rene6262/FAllyx_EVK/Fallyx_EVK _BOM.xlsx

Fallyx_EVK BOM |  | RevA
Estimated Cost | $36.61
Designator | Mfg | Mfg Part ID | Description | QTY | COST/100 | Value | Footprint | ALT P/N
C1, C5, C7, C8, C15, C16, C19, C20, C21, C22, C26, C28, C36 | YAGEO | CC0603KRX7R7BB104 | CAP CER 0.1UF 16V X7R 0603 | 13 | $0.02 | 0.1uF | C0603
C2, C6, C14, C27, C41, C44 | Samsung Electro-Mechanics | CL10A475KP8NNNC | CAP CER 4.7UF 10V X5R 0603 | 6 | $0.02 | 4.7uF | C0603
C3, C45 | KEMET | C0603C151J5GACTU | CAP CER 150PF 50V C0G/NP0 0603 | 1 | $0.02 | 150pF | C0603
C4, C45 | Murata Electronics | GRM21BR61C106KE15K | CAP CER 10UF 16V X5R 0805 | 1 | $0.05 | 10uF | C0805
C23, C31, C35, C37 | Taiyo Yuden | JMK105BJ105KV-F | CAP CER 1UF 6.3V X5R 0402 | 4 | $0.01 | 1uF | C0402
C29, C30 | Murata Electronics | GRM155R60J106ME05D | CAP CER 10UF 6.3V X5R 0402 | 2 | $0.02 | 10uF | C0402
C33 | Samsung Electro-Mechanics | CL10A225KO8NNNC | CAP CER 2.2UF 16V X5R 0603 | 1 | $0.02 | 2.2uF | C0603
C38 | Murata Electronics | GCM155R71H223KA55D | CAP CER 0.022UF 50V X7R 0402 | 1 | $0.01 | 22nF | C0402
C17, C18, C24, C25, C39 | Murata Electronics | GRM1555C1H100JA01D | CAP CER 10PF 50V C0G/NP0 0402 | 5 | $0.01 | 10pF | C0402
C32 | Murata Electronics | GRM155R61A474KE15D | CAP CER 0.47UF 10V X5R 0402 | 1 | $0.04 | 0.47uF | C0402
C34, C40 | Samsung Electro-Mechanics | CL10A226MP8NUNE | CAP CER 22UF 10V X5R 0603 | 2 | $0.07 | 22uF | C0603
C42, C43 | Johanson Technology Inc. | QSCF500Q1R2B1GV001T | CAP CER 1.2PF 50V C0G/NP0 0402 | 2 | $0.05 | 1.2pF | C0402
D1 | Würth Elektronik | 150060VS75000 | LED GREEN CLEAR 0603 SMD | 1 | $0.11 |  | C0603
D2 | Würth Elektronik | 150060SS75000 | LED RED CLEAR 0603 SMD | 1 | $0.11 |  | C0603
D3 | Würth Elektronik | 150060AS75000 | LED AMBER CLEAR 0603 SMD | 1 | $0.11 |  | C0603
D4, D6 | Kingbright | APG0603SURC-TT | LED RED CLEAR 2SMD | 1 | $0.19 |  | C0201
D5 | onsemi | RB521S30T1G | DIODE SCHOTTKY 30V 200MA SOD523 | DNP | $0.04 |  | SOD523
FB2 | Würth Elektronik | 7427927261 | FERRITE BEAD 600 OHM 0402 4LN | 1 | $0.15
J1 |  |  | 5PIN | DNP
J2, J3 |  |  | 6PIN | DNP
J4 |  |  | 8PIN | DNP
J5 |  |  | DNP | DNP
J6 | GCT | USB4135-GF-A | USB C REC GF RA 6P SMT & SMT SHE | 1 | $0.44
J9 | Hirose Electric Co Ltd | U.FL-R-SMT-1(80) | CONN U.FL RCPT STR 50 OHM SMD | 1 | $0.78
J12 |  |  | 40PIN | DNP
J13 |  |  | 9PIN | DNP
L1, L3 | Taiyo Yuden | NR3015T4R7M | FIXED IND 4.7UH 1.04A 144MOHM SM | 2 | $0.19 | 4.7uH
L2 | TDK Corporation | MLG1005S3N3ST000 | FIXED IND 3.3NH 800MA 200MOHM SM | 1 | $0.07 | 3.3nH | L0402
R1, R27 | Panasonic Electronic Components | ERJ-6GEY0R00V | RES SMD 0 OHM JUMPER 1/8W 0805 | 1 | $0.02 | 0Ohm | R0805
R2 | TE Connectivity Passive Product | CPF0402B200KE | RES SMD 200K OHM 0.1% 1/16W 0402 | 1 | $0.16 | 200kOhm | R0402
R3 | TE Connectivity Passive Product | CPF0402B150KE1 | RES SMD 150K OHM 0.1% 1/16W 0402 | 1 | $0.20 | 150kOhm | R0402
R16, R17 | Panasonic Electronic Components | ERA-2AEB512X | RES SMD 5.1K OHM 0.1% 1/16W 0402 | 2 | $0.09 | 5.1k | R0402
R8, R19 | YAGEO | RC0402JR-07100KL | RES 100K OHM 5% 1/16W 0402 | DNP | $0.0041 | 100k | R0402
R9, R10 | YAGEO | RC0402JR-07100KL | RES 100K OHM 5% 1/16W 0402 | 2 | $0.0041 | 100k | R0402
R4, R5, R6, R7, R18, R14, R15, R28 | YAGEO | RC0402JR-0710KL | RES 10K OHM 5% 1/16W 0402 | 8 | $0.01 | 10k | R0402
R20, R23, R24, R25, R26, R29 | YAGEO | RC0402JR-071KL | RES 1K OHM 5% 1/16W 0402 | 6 | $0.01 | 1k | R0402
R30 | YAGEO | RC0402JR-074K7L | RES 4.7K OHM 5% 1/16W 0402 | 1 | $0.0041 | 4.7k | R0402
R31 | TE Connectivity Passive Product | CRGCQ0402F330K | RES 330K OHM 1% 1/16W 0402 | 1 | $0.01 | 330k | R0402
R32 | Panasonic Electronic Components | ERJ-2RKF1603X | RES SMD 160K OHM 1% 1/10W 0402 | 1 | $0.01 | 160k | R0402
S1 | Same Sky (Formerly CUI Devices) | TS04-66-50-BK-100-SMT | SWITCH TACTILE SPST-NO 0.05A 12V | 1 | $0.14
Q1 | Infineon Technologies | IRLML6344TRPBF | MOSFET N-CH 30V 5A MICRO3/SOT23 | 1 | $0.18 |  | SOT23
Q2 | LRC | LMBT3904WT1G | 40V 150mW 40@0.1mA,10V 200mA NPN SOT-323-3 Bipolar (BJT) ROHS | 1 | $0.01 |  | SOT323
IC1 | onsemi | NCH-RSL10-101S51-ACG | IC RF TXRX+MCU BLE 51SIP | 1 | $11.17
IC2 | Silicon Labs | BGM111A256V21R | RF TXRX MOD BLUETOOTH CHIP SMD | 1 | $8.93
U1, U10 | Torex Semiconductor Ltd | XC9236F08CER-G | IC REG BUCK ADJ 600MA 6USPC | 1 | $1.29 |  | 6-UFDFN
U2 | STMicroelectronics | ILPS22QSTR | SENSOR 58.89PSIA 24BIT 10HLGA | 1 | $2.49 |  | 10-WFLGA
U3 | Bosch Sensortec | BMI270 | IMU ACCEL/GYRO I2C/SPI 14LGA | 1 | $3.03 |  | 14HLGA
U4 | STMicroelectronics | STM32L431CBT6 | IC MCU 32BIT 128KB FLASH 48LQFP | 1 | $2.12 |  | 48-LQFP
U5 | Macronix | MX25R6435FZNIL0 | IC FLASH 64MBIT SPI/QUAD 8WSON | 1 | $1.55
U6 | Microchip Technology | MCP73831T-2ACI/OT | IC BATT CNTL LI-ION 1CEL SOT23-5 | 1 | $0.61 |  | SOT235
X1 | ECS Inc. | ECS-320-CDX-2094 | CRYSTAL 32.000MHZ 10PF SMD | 1 | $0.40
X2 | Jauch Quartz | Q 0,032768-JTX110-9-20-T1-90K-LF | CRYSTAL 32.7680KHZ 9PF SMD | 1 | $0.78
