rene6262/FAllyx_EVK/Fallyx_EVK-RevA.kicad_pcb

## KiCad design Fallyx_EVK-RevA.kicad_pcb (2025-02-08)

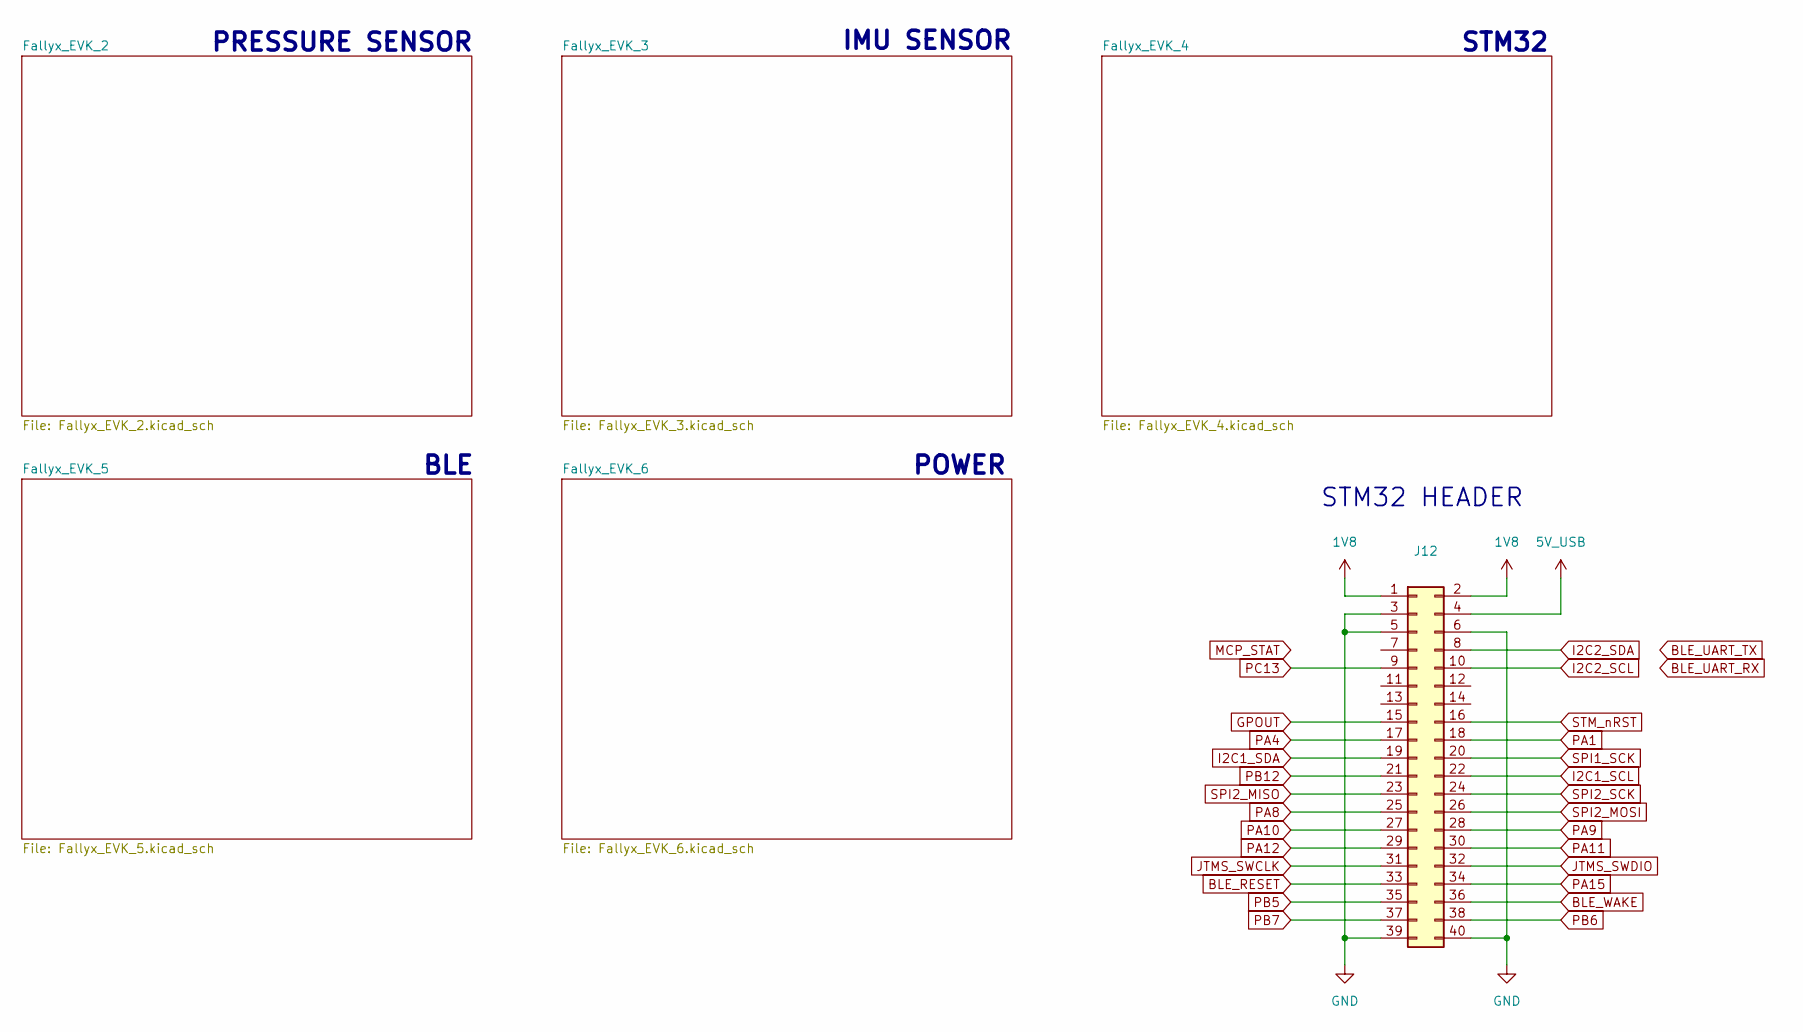
[picture p1: schematic Fallyx_EVK-RevA.kicad_sch]

Parts:
J12: Conn_02x20_Odd_Even; PinHeader_2x20_P2.54mm_Vertical

Connections:
1V8: J12.1, J12.2; also elsewhere on the board
5V_USB: J12.4; also elsewhere on the board
BLE_RESET: J12.33; also elsewhere on the board
BLE_UART_RX: J12.10; also elsewhere on the board
BLE_UART_TX: J12.8; also elsewhere on the board
BLE_WAKE: J12.36; also elsewhere on the board
GND: J12.3, J12.5, J12.6, J12.39, J12.40; also elsewhere on the board
GPOUT: J12.15; also elsewhere on the board
I2C1_SCL: J12.22; also elsewhere on the board
I2C1_SDA: J12.19; also elsewhere on the board
JTMS_SWCLK: J12.31; also elsewhere on the board
JTMS_SWDIO: J12.32; also elsewhere on the board
PA1: J12.18; also elsewhere on the board
PA4: J12.17; also elsewhere on the board
PA8: J12.25; also elsewhere on the board
PA9: J12.28; also elsewhere on the board
PA10: J12.27; also elsewhere on the board
PA11: J12.30; also elsewhere on the board
PA12: J12.29; also elsewhere on the board
PA15: J12.34; also elsewhere on the board
PB5: J12.35; also elsewhere on the board
PB6: J12.38; also elsewhere on the board
PB7: J12.37; also elsewhere on the board
PB12: J12.21; also elsewhere on the board
PC13: J12.9; also elsewhere on the board
SPI1_SCK: J12.20; also elsewhere on the board
SPI2_MISO: J12.23; also elsewhere on the board
SPI2_MOSI: J12.26; also elsewhere on the board
SPI2_SCK: J12.24; also elsewhere on the board
STM_nRST: J12.16; also elsewhere on the board

Notes on the sheet:
STM32 HEADER
BLE
POWER
STM32
IMU SENSOR
PRESSURE SENSOR

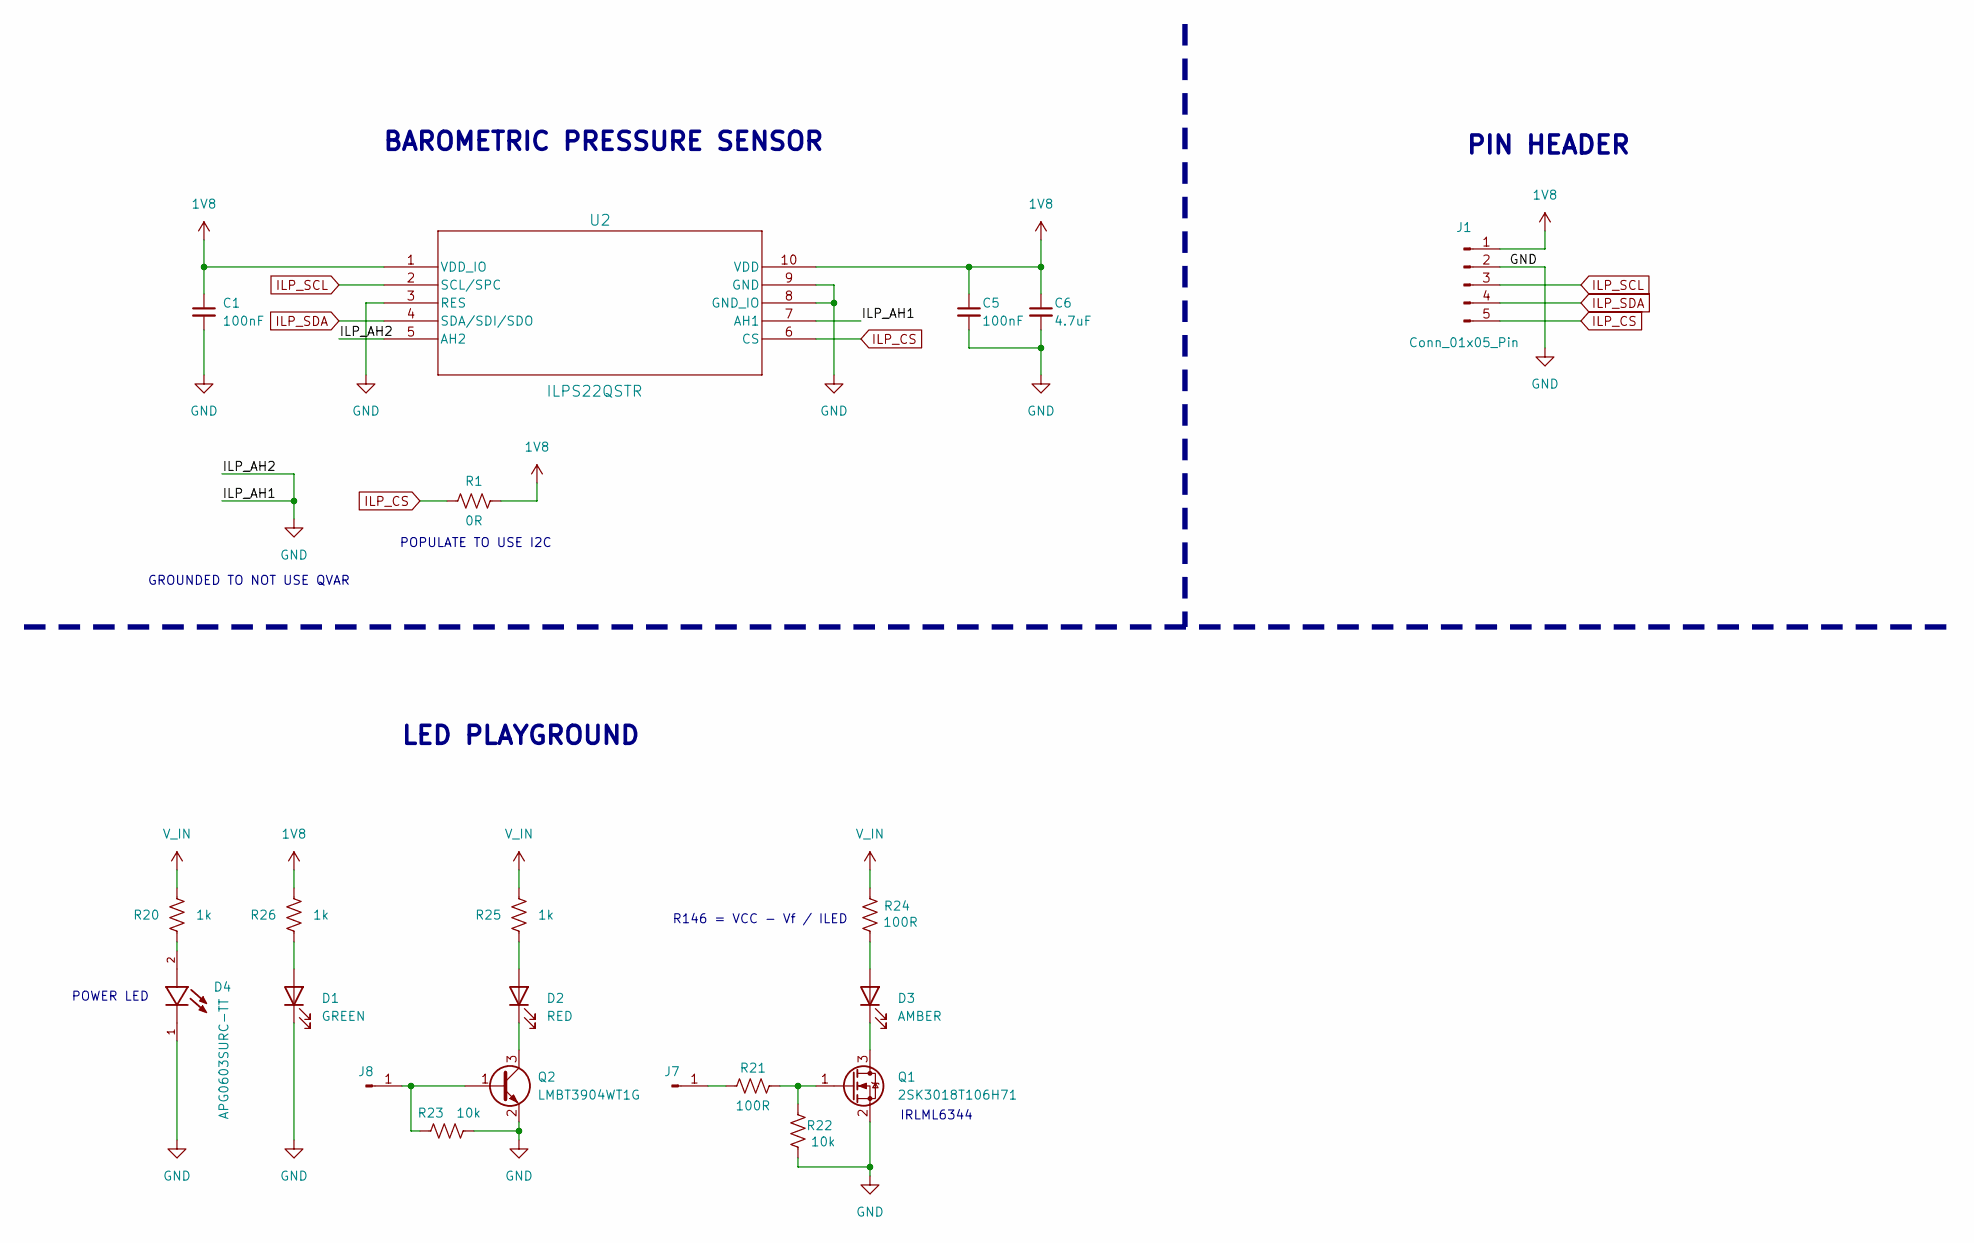
[picture p2: schematic Fallyx_EVK_2.kicad_sch]

Parts:
C1, C5: 100nF; C_0603_1608Metric
C6: 4.7uF; C_0603_1608Metric
D1: GREEN; LED_0603_1608Metric
D2: RED; LED_0603_1608Metric
D3: AMBER; LED_0603_1608Metric
D4: APG0603SURC-TT; LED_APG0603SURC-TT; PARTREV V.9B
J1: Conn_01x05_Pin; PinHeader_1x05_P2.54mm_Vertical
J7, J8: Conn_01x01_Pin; PinHeader_1x01_P2.54mm_Vertical
Q1: 2SK3018T106H71; SOT-323_SC-70
Q2: LMBT3904WT1G; SOT-23
R1: 0R; R_0805_2012Metric
R20, R25, R26: 1k; R_0402_1005Metric
R21, R24: 100R; R_0402_1005Metric
R22, R23: 10k; R_0402_1005Metric
U2: ILPS22QSTR; HLGA_10L_STM

Connections:
1V8: C1.1, C5.1, C6.1, J1.1, R1.2, R26.1, U2.1 (VDD_IO), U2.10 (VDD); also elsewhere on the board
GND: C1.2, C5.2, C6.2, D1.1 (K), D4.1, J1.2, Q1.2 (S), Q2.2 (E), R22.2, R23.1, U2.3 (RES), U2.5 (AH2), U2.7 (AH1), U2.8 (GND_IO), U2.9 (GND); also elsewhere on the board
ILP_CS: J1.5, R1.1, U2.6 (CS)
ILP_SCL: J1.3, U2.2 (SCL/SPC)
ILP_SDA: J1.4, U2.4 (SDA/SDI/SDO)
unnamed: D1.2 (A), R26.2
unnamed: D2.2 (A), R25.2
unnamed: D2.1 (K), Q2.3 (C)
unnamed: D3.2 (A), R24.2
unnamed: D3.1 (K), Q1.3 (D)
unnamed: D4.2, R20.2
unnamed: J7.1, R21.2
unnamed: J8.1, Q2.1 (B), R23.2
unnamed: Q1.1 (G), R21.1, R22.1
V_IN: R20.1, R24.1, R25.1; also elsewhere on the board

Notes on the sheet:
GROUNDED TO NOT USE QVAR
PIN HEADER
POPULATE TO USE I2C
IRLML6344
BAROMETRIC PRESSURE SENSOR
LED PLAYGROUND
POWER LED
R146 = VCC - Vf / ILED

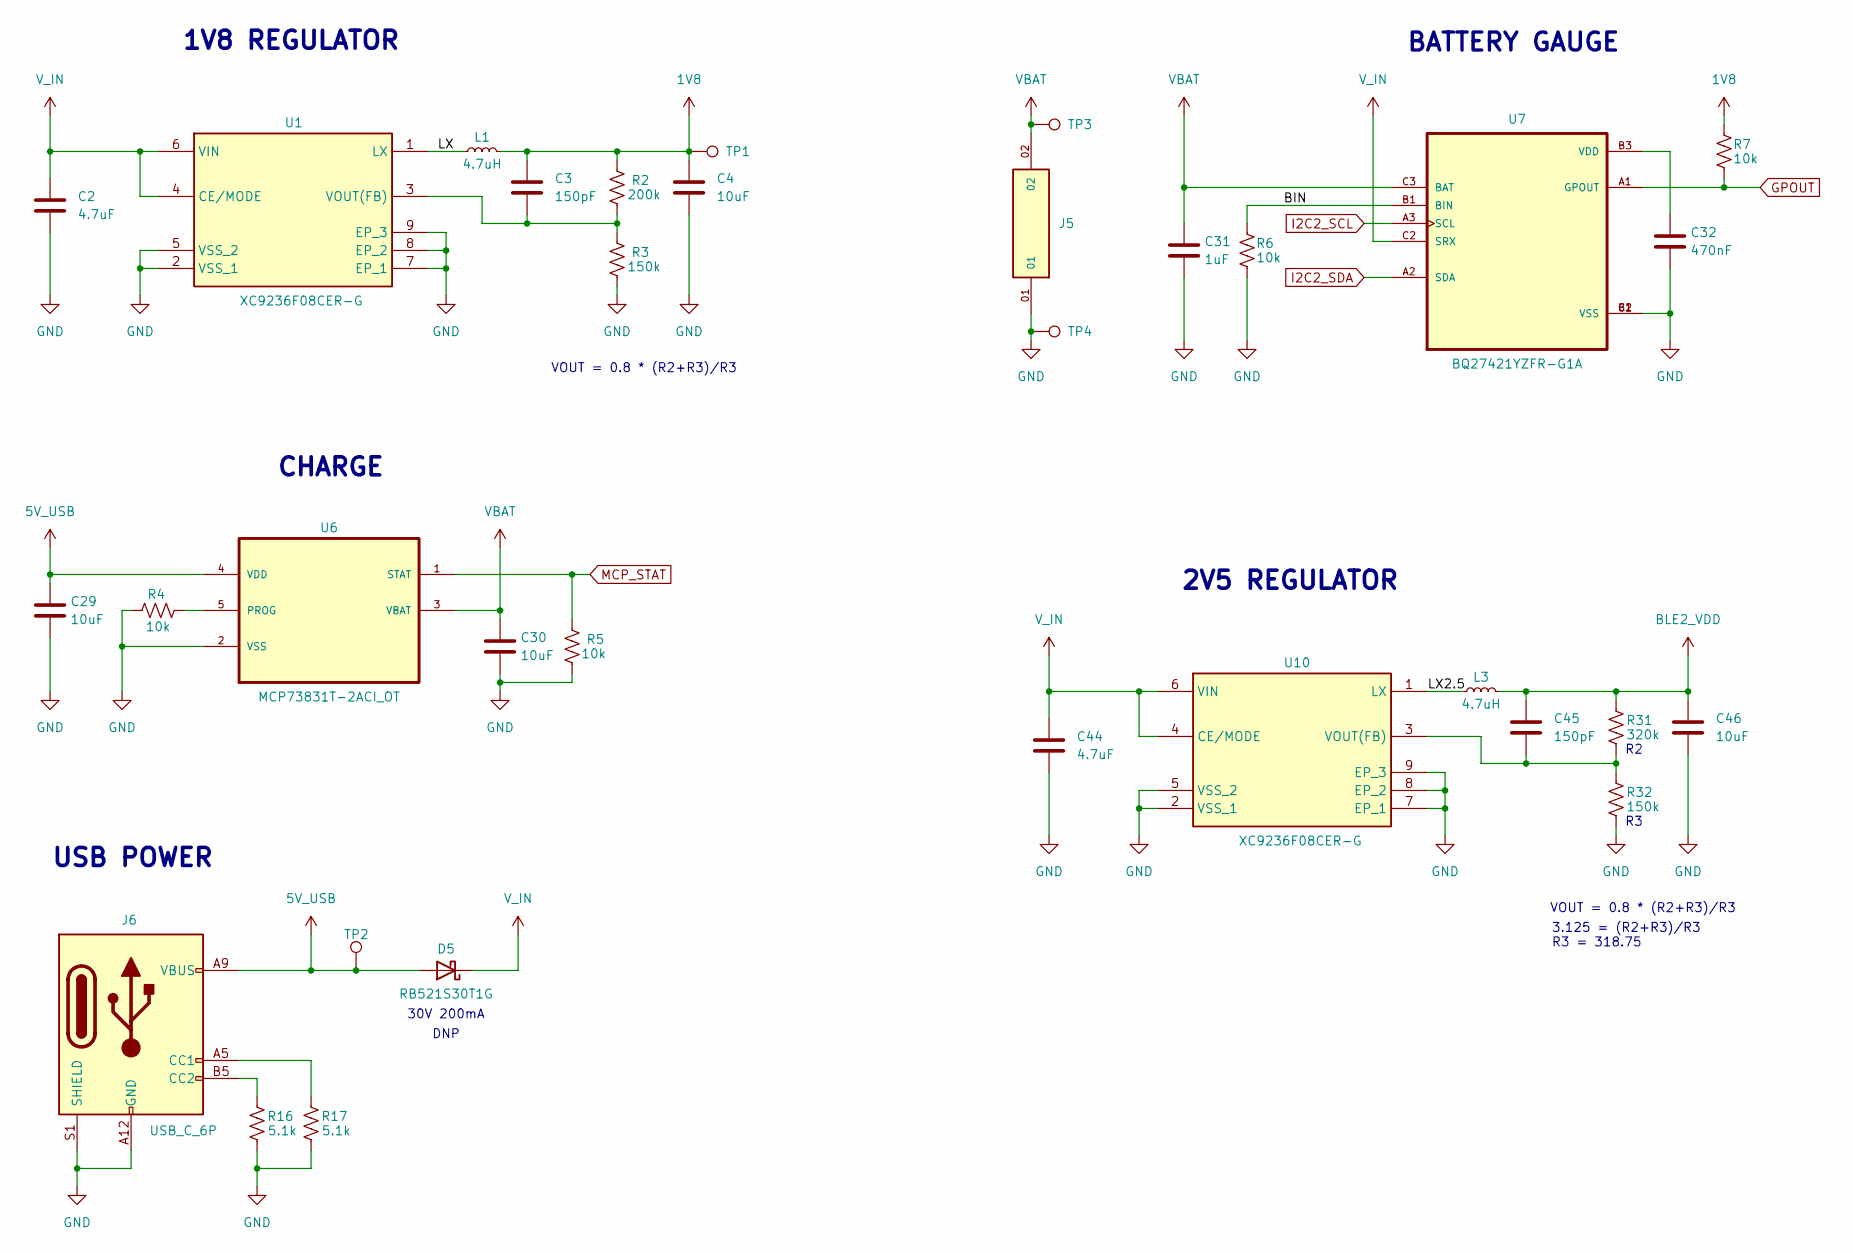
[picture p3: schematic Fallyx_EVK_6.kicad_sch]

Parts:
C2, C44: 4.7uF; C_0603_1608Metric
C3, C45: 150pF; C_0603_1608Metric
C4, C46: 10uF; C_0805_2012Metric
C29, C30: 10uF; C_0402_1005Metric
C31: 1uF; C_0402_1005Metric
C32: 470nF; C_0402_1005Metric
D5: RB521S30T1G; DIOM168X70N
J5: MTSW-101-X-X-D-X; SAMTEC_MTSW-101-X-X-D-X; PARTREV A
J6: USB_C_6P; USB_C_Receptacle_GCT_USB4135-GF-A_6P_TopMnt_Horizontal
L1, L3: 4.7uH; IND_TAIYO_NR3015_TAY
R2: 200k; R_0402_1005Metric
R3, R32: 150k; R_0402_1005Metric
R4, R5, R6, R7: 10k; R_0402_1005Metric
R16, R17: 5.1k; R_0402_1005Metric
R31: 320k; R_0402_1005Metric
TP1, TP2, TP3, TP4: TestPoint; TestPoint_Pad_D1.5mm
U1, U10: XC9236F08CER-G; XC9236F08CERG; Mouser Part Number 865-XC9236F08CER-G
U6: MCP73831T-2ACI_OT; SOT95P280X145-5N; MPN MCP73831T-2ACI/OT
U7: BQ27421YZFR-G1A; IC_BQ27421YZFR-G1A

Connections:
1V8: C3.1, C4.1, L1.2, R2.2, R7.2, TP1.1; also elsewhere on the board
5V_USB: C29.1, D5.2 (A), J6.A9 (VBUS), J6.B9 (VBUS), TP2.1, U6.4 (VDD); also elsewhere on the board
/Fallyx_EVK_6/BIN: R6.2, U7.B1 (BIN)
/Fallyx_EVK_6/LX: L1.1, U1.1 (LX)
/Fallyx_EVK_6/LX2.5: L3.1, U10.1 (LX)
BLE2_VDD: C45.1, C46.1, L3.2, R31.2; also elsewhere on the board
BLE_UART_RX: U7.A3 (SCL); also elsewhere on the board
BLE_UART_TX: U7.A2 (SDA); also elsewhere on the board
GND: C2.2, C4.2, C29.2, C30.2, C31.2, C32.2, C44.2, C46.2, J5.01, J6.A12 (GND), J6.B12 (GND), J6.S1 (SHIELD), R3.1, R4.2, R5.1, R6.1, R16.1, R17.1, R32.1, TP4.1, U1.2 (VSS_1), U1.5 (VSS_2), U1.7 (EP_1), U1.8 (EP_2), U1.9 (EP_3), U6.2 (VSS), U7.B2 (VSS), U7.C1 (VSS), U10.2 (VSS_1), U10.5 (VSS_2), U10.7 (EP_1), U10.8 (EP_2), U10.9 (EP_3); also elsewhere on the board
GPOUT: R7.1, U7.A1 (GPOUT); also elsewhere on the board
MCP_STAT: R5.2, U6.1 (STAT); also elsewhere on the board
unnamed: J6.A5 (CC1), R17.2
unnamed: J6.B5 (CC2), R16.2
unnamed: C3.2, R2.1, R3.2, U1.3 (VOUT(FB))
unnamed: R4.1, U6.5 (PROG)
unnamed: C32.1, U7.B3 (VDD)
unnamed: C45.2, R31.1, R32.2, U10.3 (VOUT(FB))
VBAT: C30.1, C31.1, J5.02, TP3.1, U6.3 (VBAT), U7.C3 (BAT); also elsewhere on the board
V_IN: C2.1, C44.1, D5.1 (K), U1.4 (CE/MODE), U1.6 (VIN), U7.C2 (SRX), U10.4 (CE/MODE), U10.6 (VIN); also elsewhere on the board

Notes on the sheet:
USB POWER
VOUT = 0.8 * (R2+R3)/R3
30V 200mA
1V8 REGULATOR
DNP
BATTERY GAUGE
3.125 = (R2+R3)/R3 R3 = 318.75
CHARGE
2V5 REGULATOR

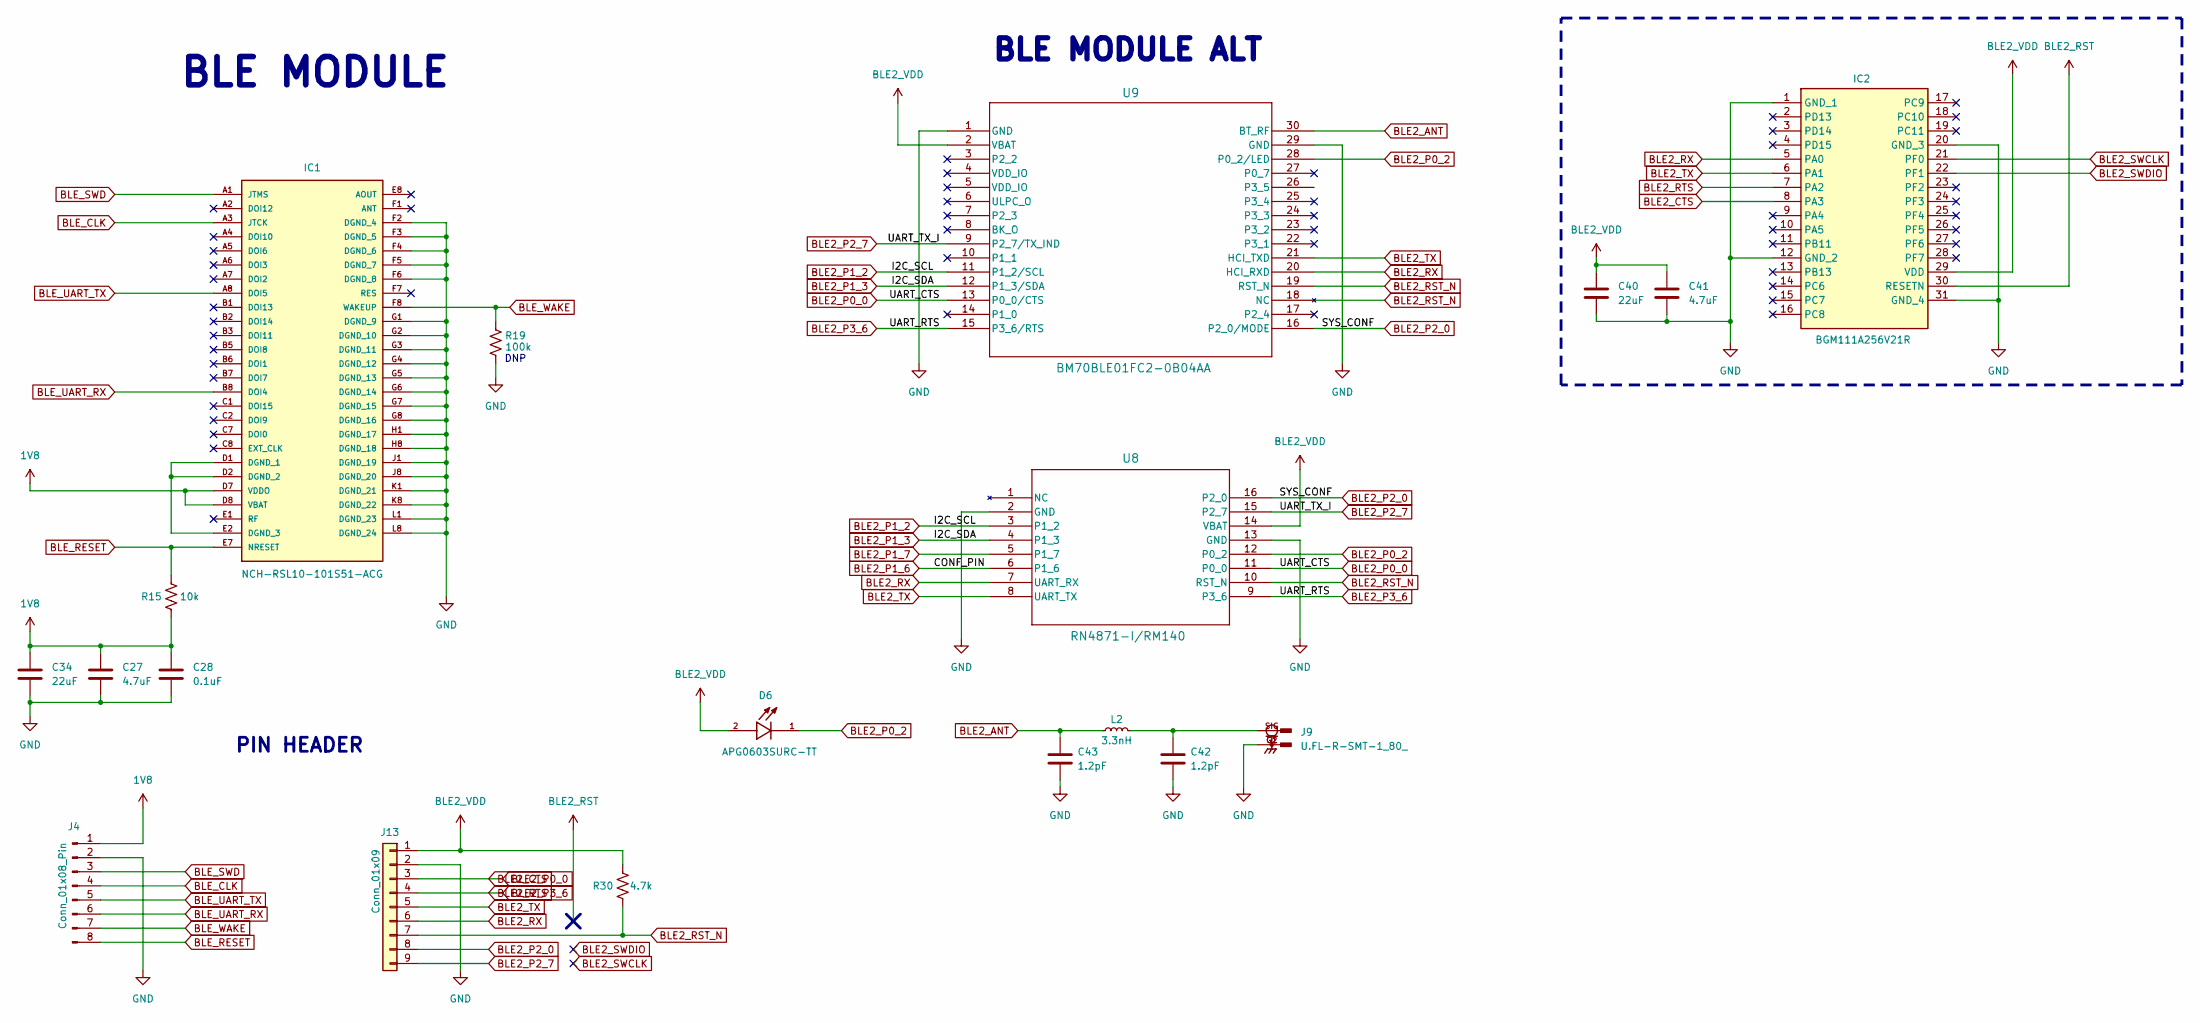
[picture p4: schematic Fallyx_EVK_5.kicad_sch]

Parts:
C27, C41: 4.7uF; C_0603_1608Metric
C28: 0.1uF; C_0402_1005Metric
C34, C40: 22uF; C_0603_1608Metric
C42, C43: 1.2pF; C_0402_1005Metric
D6: APG0603SURC-TT; LED_APG0603SURC-TT; PARTREV V.9B
IC1: NCH-RSL10-101S51-ACG; NCHRSL10101S51ACG; Mouser_Part_Number 863-NCHRSL1010S51ACG
IC2: BGM111A256V21R; Mouser Part Number 634-BGM111A256V21R
J4: Conn_01x08_Pin; PinHeader_1x08_P2.54mm_Vertical
J9: U.FL-R-SMT-1_80_; HIROSE_U.FL-R-SMT-1_80_; PARTREV Jul.1.2022
J13: Conn_01x09; PinHeader_1x09_P2.54mm_Vertical
L2: 3.3nH; L_0402_1005Metric
R15: 10k; R_0402_1005Metric
R19: 100k; R_0402_1005Metric
R30: 4.7k; R_0402_1005Metric
U8: RN4871-I/RM140; Microchip_RN4871
U9: BM70BLE01FC2-0B04AA; BM70BLE01FC2_MCH

Connections:
1V8: C27.1, C28.1, C34.1, IC1.D7 (VDDO), IC1.D8 (VBAT), J4.1, R15.1; also elsewhere on the board
BLE2_ANT: C43.1, L2.1, U9.30 (BT_RF)
BLE2_CTS: IC2.8 (PA3), J13.3, U8.11 (P0_0), U9.13 (P0_0/CTS)
BLE2_P0_2: D6.1, U8.12 (P0_2), U9.28 (P0_2/LED)
BLE2_P1_2: U8.3 (P1_2), U9.11 (P1_2/SCL)
BLE2_P1_3: U8.4 (P1_3), U9.12 (P1_3/SDA)
BLE2_P1_6: U8.6 (P1_6)
BLE2_P1_7: U8.5 (P1_7)
BLE2_P2_0: J13.8, U8.16 (P2_0), U9.16 (P2_0/MODE)
BLE2_P2_7: J13.9, U8.15 (P2_7), U9.9 (P2_7/TX_IND)
BLE2_P3_6: IC2.7 (PA2), J13.4, U8.9 (P3_6), U9.15 (P3_6/RTS)
BLE2_RST_N: J13.7, R30.1, U8.10 (RST_N), U9.18 (NC), U9.19 (RST_N)
BLE2_RX: IC2.5 (PA0), J13.6, U8.7 (UART_RX), U9.20 (HCI_RXD)
BLE2_TX: IC2.6 (PA1), J13.5, U8.8 (UART_TX), U9.21 (HCI_TXD)
BLE2_VDD: C40.1, C41.1, D6.2, IC2.29 (VDD), J13.1, R30.2, U8.14 (VBAT), U9.2 (VBAT); also elsewhere on the board
BLE_CLK: IC1.A3 (JTCK), J4.4
BLE_RESET: IC1.E7 (NRESET), J4.8, R15.2; also elsewhere on the board
BLE_SWD: IC1.A1 (JTMS), J4.3
BLE_UART_RX: IC1.B8 (DOI4), J4.6; also elsewhere on the board
BLE_UART_TX: IC1.A8 (DOI5), J4.5; also elsewhere on the board
BLE_WAKE: IC1.F8 (WAKEUP), J4.7, R19.2; also elsewhere on the board
GND: C27.2, C28.2, C34.2, C40.2, C41.2, C42.2, C43.2, IC1.F2 (DGND_4), IC1.F3 (DGND_5), IC1.F4 (DGND_6), IC1.F5 (DGND_7), IC1.F6 (DGND_8), IC1.G1 (DGND_9), IC1.G2 (DGND_10), IC1.G3 (DGND_11), IC1.G4 (DGND_12), IC1.G5 (DGND_13), IC1.G6 (DGND_14), IC1.G7 (DGND_15), IC1.G8 (DGND_16), IC1.H1 (DGND_17), IC1.H8 (DGND_18), IC1.J1 (DGND_19), IC1.J8 (DGND_20), IC1.K1 (DGND_21), IC1.K8 (DGND_22), IC1.L1 (DGND_23), IC1.L8 (DGND_24), IC2.1 (GND_1), IC2.12 (GND_2), IC2.20 (GND_3), IC2.31 (GND_4), J4.2, J9.G1, J9.G2, J13.2, R19.1, U8.2 (GND), U8.13 (GND), U9.1 (GND), U9.29 (GND); also elsewhere on the board
unnamed: C42.1, J9.SIG, L2.2
unnamed: IC1.D1 (DGND_1), IC1.D2 (DGND_2), IC1.E2 (DGND_3)

Notes on the sheet:
PIN HEADER
DNP
BLE MODULE
BLE MODULE ALT

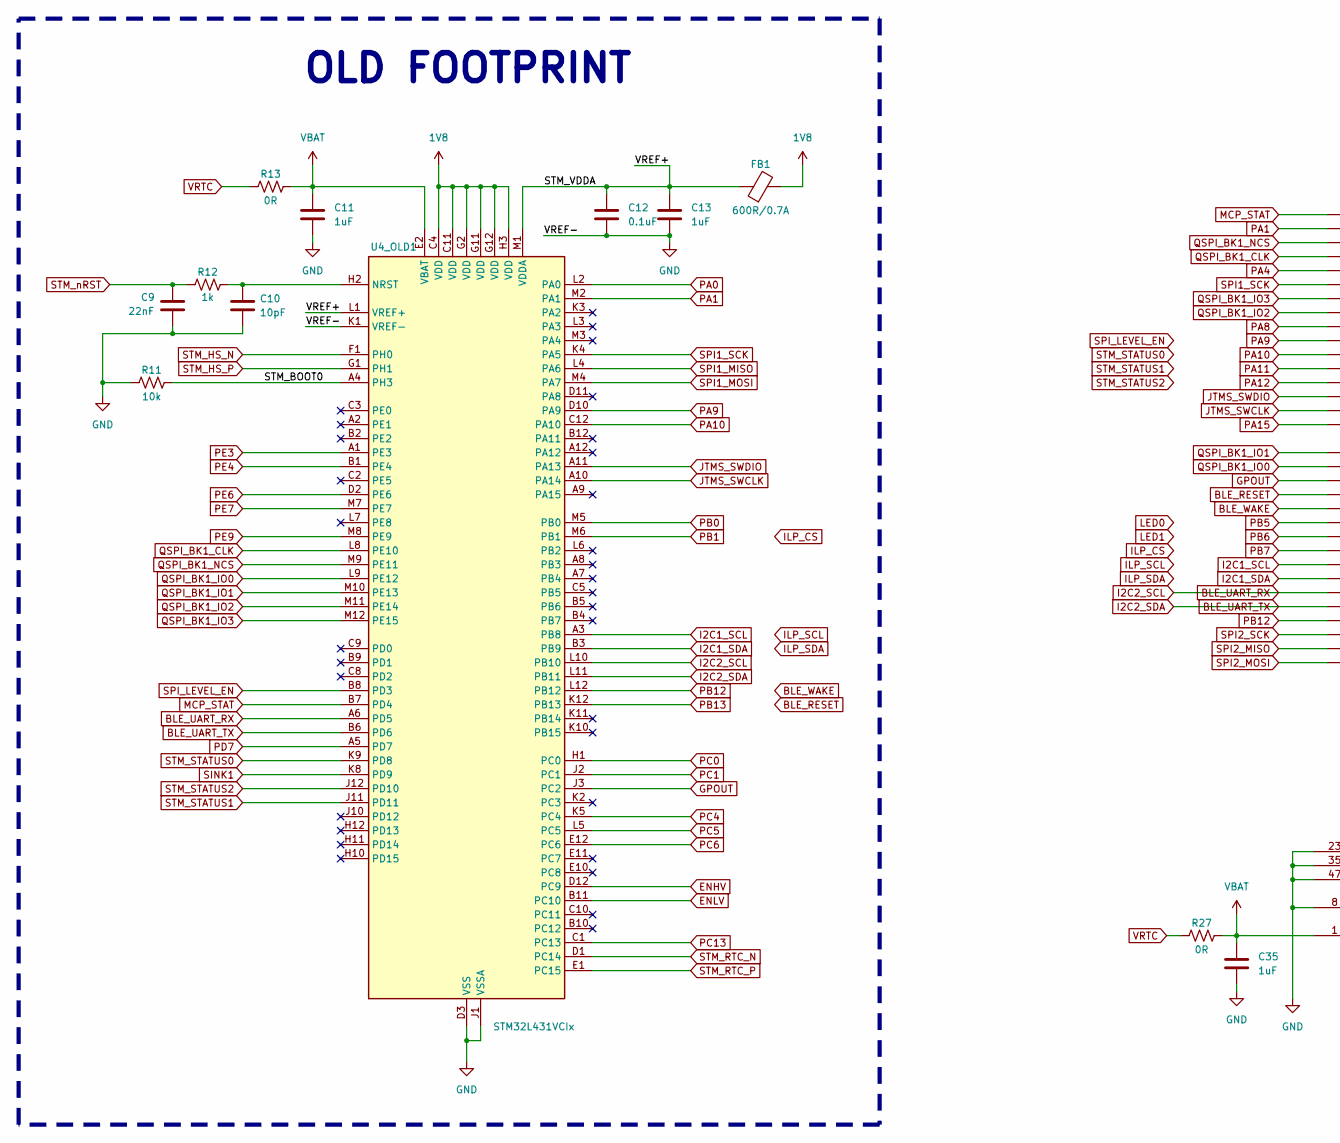
[picture p5: schematic Fallyx_EVK_4.kicad_sch, part in row 1, column 1]

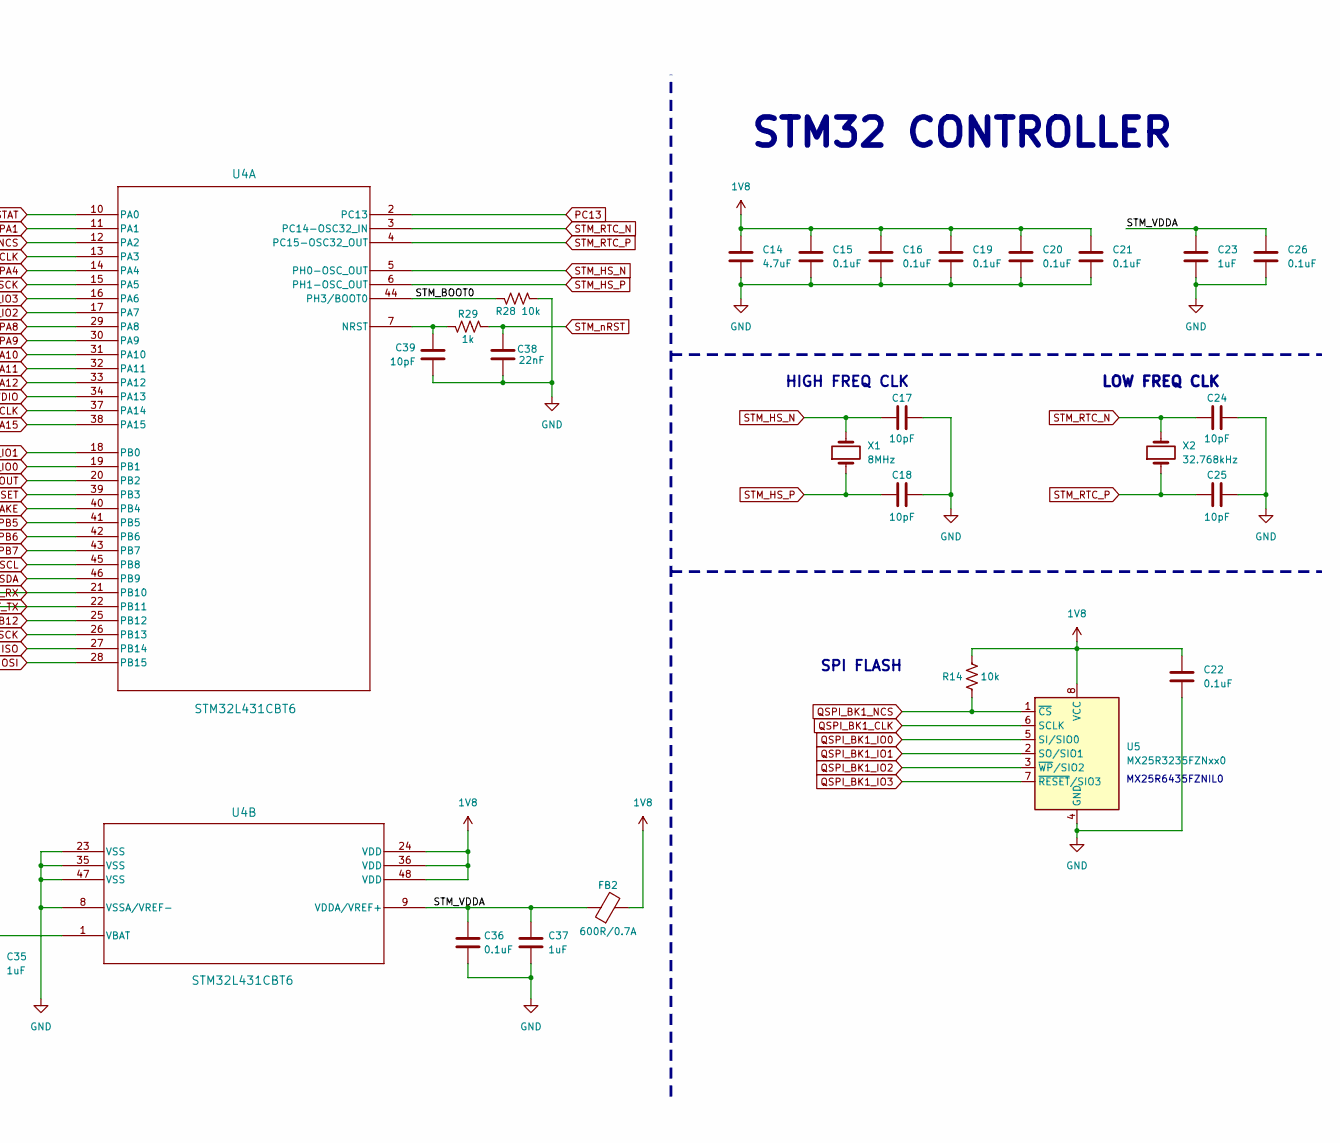
[picture p6: schematic Fallyx_EVK_4.kicad_sch, part in row 1, column 2]

Parts:
C9, C38: 22nF; C_0402_1005Metric
C10, C17, C18, C24, C25, C39: 10pF; C_0402_1005Metric
C11, C13, C23, C35, C37: 1uF; C_0402_1005Metric
C12, C15, C16, C19, C20, C21, C22, C26, C36: 0.1uF; C_0402_1005Metric
C14: 4.7uF; C_0603_1608Metric
FB1: 600R/0.7A
FB2: 600R/0.7A; R_0402_1005Metric
R11, R14, R28: 10k; R_0402_1005Metric
R12, R29: 1k; R_0402_1005Metric
R13, R27: 0R; R_0805_2012Metric
U4: STM32L431CBT6; LQFP-48
U4_OLD1: STM32L431VCIx; UFBGA-100_7x7mm_Layout12x12_P0.5mm
U5: MX25R3235FZNxx0; WSON-8-1EP_6x5mm_P1.27mm_EP3.4x4mm
X1: 8MHz; XTAL_ECS-320-CDX-2094
X2: 32.768kHz; XTAL_CM9V-T1A-32.768KHZ-7PF-100PPM-TA-QC

Connections:
1V8: C14.1, C15.1, C16.1, C19.1, C20.1, C21.1, C22.1, FB1.2, FB2.2, R14.2, U4.24 (VDD), U4.36 (VDD), U4.48 (VDD), U4_OLD1.C4 (VDD), U4_OLD1.C11 (VDD), U4_OLD1.G2 (VDD), U4_OLD1.G11 (VDD), U4_OLD1.G12 (VDD), U4_OLD1.H3 (VDD), U5.8 (VCC); also elsewhere on the board
/Fallyx_EVK_4/STM_BOOT0: R11.2, R28.2, U4.44 (PH3/BOOT0), U4_OLD1.A4 (PH3)
/Fallyx_EVK_4/STM_VDDA: C12.1, C13.1, C23.1, C26.1, C36.1, C37.1, FB1.1, FB2.1, U4.9 (VDDA/VREF+), U4_OLD1.L1 (VREF+), U4_OLD1.M1 (VDDA)
BLE_RESET: U4.39 (PB3); also elsewhere on the board
BLE_UART_RX: U4.21 (PB10), U4_OLD1.A6 (PD5), U4_OLD1.L10 (PB10); also elsewhere on the board
BLE_UART_TX: U4.22 (PB11), U4_OLD1.B6 (PD6), U4_OLD1.L11 (PB11); also elsewhere on the board
BLE_WAKE: U4.40 (PB4); also elsewhere on the board
GND: C9.2, C10.2, C11.2, C12.2, C13.2, C14.2, C15.2, C16.2, C17.2, C18.2, C19.2, C20.2, C21.2, C22.2, C23.2, C24.2, C25.2, C26.2, C35.2, C36.2, C37.2, C38.2, C39.2, R11.1, R28.1, U4.8 (VSSA/VREF-), U4.23 (VSS), U4.35 (VSS), U4.47 (VSS), U4_OLD1.D3 (VSS), U4_OLD1.E3 (VSS), U4_OLD1.F2 (VSS), U4_OLD1.F11 (VSS), U4_OLD1.F12 (VSS), U4_OLD1.J1 (VSSA), U4_OLD1.K1 (VREF-), U5.4 (GND), U5.9 (GND); also elsewhere on the board
GPOUT: U4.20 (PB2), U4_OLD1.J3 (PC2); also elsewhere on the board
I2C1_SCL: U4.45 (PB8), U4_OLD1.A3 (PB8); also elsewhere on the board
I2C1_SDA: U4.46 (PB9), U4_OLD1.B3 (PB9); also elsewhere on the board
JTMS_SWCLK: U4.37 (PA14), U4_OLD1.A10 (PA14); also elsewhere on the board
JTMS_SWDIO: U4.34 (PA13), U4_OLD1.A11 (PA13); also elsewhere on the board
MCP_STAT: U4.10 (PA0), U4_OLD1.B7 (PD4); also elsewhere on the board
unnamed: C10.1, R12.2, U4_OLD1.H2 (NRST)
unnamed: C39.1, R29.2, U4.7 (NRST)
PA1: U4.11 (PA1), U4_OLD1.M2 (PA1); also elsewhere on the board
PA4: U4.14 (PA4); also elsewhere on the board
PA8: U4.29 (PA8); also elsewhere on the board
PA9: U4.30 (PA9), U4_OLD1.D10 (PA9); also elsewhere on the board
PA10: U4.31 (PA10), U4_OLD1.C12 (PA10); also elsewhere on the board
PA11: U4.32 (PA11); also elsewhere on the board
PA12: U4.33 (PA12); also elsewhere on the board
PA15: U4.38 (PA15); also elsewhere on the board
PB5: U4.41 (PB5); also elsewhere on the board
PB6: U4.42 (PB6); also elsewhere on the board
PB7: U4.43 (PB7); also elsewhere on the board
PB12: U4.25 (PB12), U4_OLD1.L12 (PB12); also elsewhere on the board
PC13: U4.2 (PC13), U4_OLD1.C1 (PC13); also elsewhere on the board
QSPI_BK1_CLK: U4.13 (PA3), U4_OLD1.L8 (PE10), U5.6 (SCLK)
QSPI_BK1_IO0: U4.19 (PB1), U4_OLD1.L9 (PE12), U5.5 (SI/SIO0)
QSPI_BK1_IO1: U4.18 (PB0), U4_OLD1.M10 (PE13), U5.2 (SO/SIO1)
QSPI_BK1_IO2: U4.17 (PA7), U4_OLD1.M11 (PE14), U5.3 (~WP/SIO2)
QSPI_BK1_IO3: U4.16 (PA6), U4_OLD1.M12 (PE15), U5.7 (~RESET/SIO3)
QSPI_BK1_NCS: R14.1, U4.12 (PA2), U4_OLD1.M9 (PE11), U5.1 (~CS)
SPI1_SCK: U4.15 (PA5), U4_OLD1.K4 (PA5); also elsewhere on the board
SPI2_MISO: U4.27 (PB14); also elsewhere on the board
SPI2_MOSI: U4.28 (PB15); also elsewhere on the board
SPI2_SCK: U4.26 (PB13); also elsewhere on the board
STM_HS_N: C17.1, U4.5 (PH0-OSC_OUT), U4_OLD1.F1 (PH0), X1.2
STM_HS_P: C18.1, U4.6 (PH1-OSC_OUT), U4_OLD1.G1 (PH1), X1.1
STM_RTC_N: C24.1, U4.3 (PC14-OSC32_IN), U4_OLD1.D1 (PC14), X2.2
STM_RTC_P: C25.1, U4.4 (PC15-OSC32_OUT), U4_OLD1.E1 (PC15), X2.1
STM_nRST: C9.1, C38.1, R12.1, R29.1; also elsewhere on the board
VBAT: C11.1, C35.1, R13.2, R27.2, U4.1 (VBAT), U4_OLD1.E2 (VBAT); also elsewhere on the board
VRTC: R13.1, R27.1

Notes on the sheet:
OLD FOOTPRINT
HIGH FREQ CLK
LOW FREQ CLK
MX25R6435FZNIL0
SPI FLASH
STM32 CONTROLLER

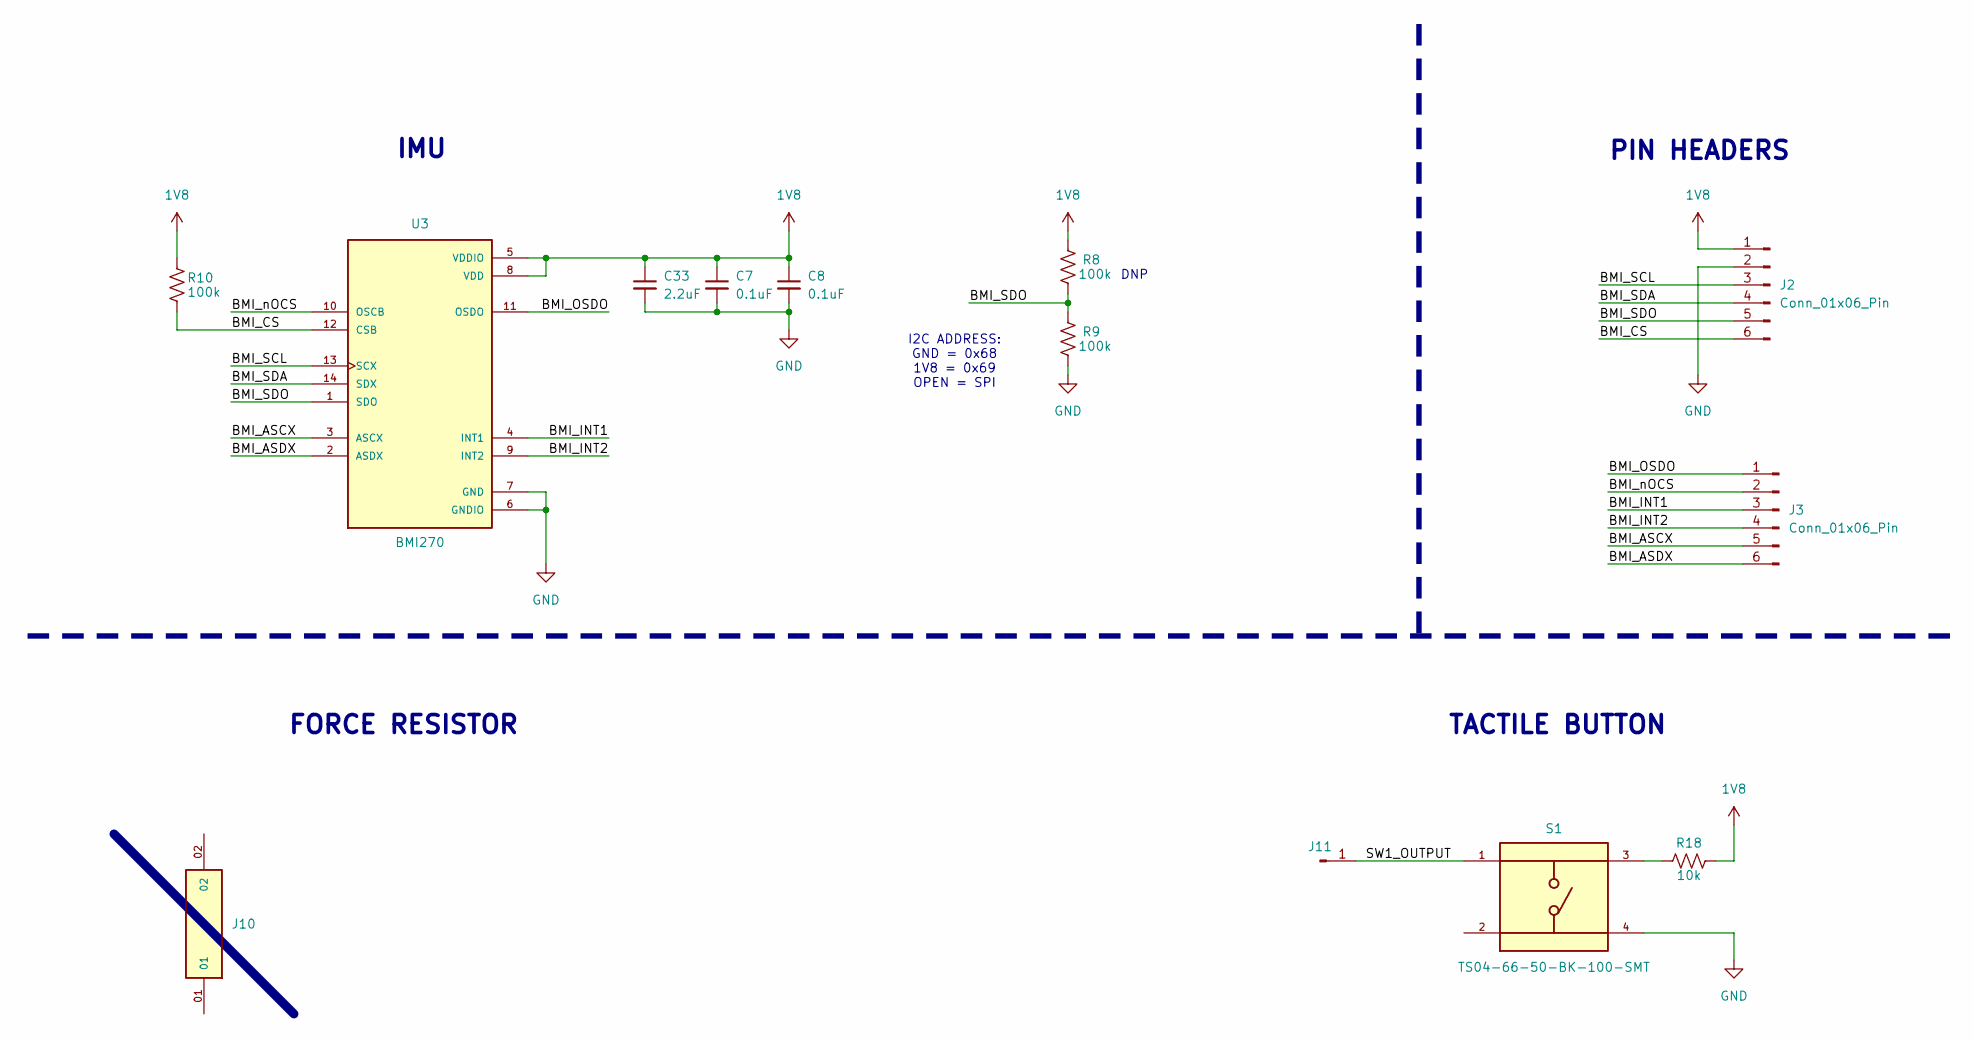
[picture p7: schematic Fallyx_EVK_3.kicad_sch]

Parts:
C7, C8: 0.1uF; C_0603_1608Metric
C33: 2.2uF; C_0603_1608Metric
J2, J3: Conn_01x06_Pin; PinHeader_1x06_P2.54mm_Vertical
J10: MTSW-101-X-X-D-X; SAMTEC_MTSW-101-X-X-D-X; PARTREV A
J11: Conn_01x01_Pin; PinHeader_1x01_P2.54mm_Vertical
R8, R9, R10: 100k; R_0402_1005Metric
R18: 10k; R_0402_1005Metric
S1: TS04-66-50-BK-100-SMT; SW_TS04-66-50-BK-100-SMT; PARTREV 1.0
U3: BMI270; XDCR_BMI270

Connections:
1V8: C7.1, C8.1, C33.1, J2.1, R8.2, R10.2, R18.1, U3.5 (VDDIO), U3.8 (VDD); also elsewhere on the board
/Fallyx_EVK_3/BMI_ASCX: J3.5, U3.3 (ASCX)
/Fallyx_EVK_3/BMI_ASDX: J3.6, U3.2 (ASDX)
/Fallyx_EVK_3/BMI_CS: J2.6, R10.1, U3.12 (CSB)
/Fallyx_EVK_3/BMI_INT1: J3.3, U3.4 (INT1)
/Fallyx_EVK_3/BMI_INT2: J3.4, U3.9 (INT2)
/Fallyx_EVK_3/BMI_OSDO: J3.1, U3.11 (OSDO)
/Fallyx_EVK_3/BMI_SCL: J2.3, U3.13 (SCX)
/Fallyx_EVK_3/BMI_SDA: J2.4, U3.14 (SDX)
/Fallyx_EVK_3/BMI_SDO: J2.5, R8.1, R9.2, U3.1 (SDO)
/Fallyx_EVK_3/BMI_nOCS: J3.2, U3.10 (OSCB)
/Fallyx_EVK_3/SW1_OUTPUT: J11.1, S1.1
GND: C7.2, C8.2, C33.2, J2.2, R9.1, S1.4, U3.6 (GNDIO), U3.7 (GND); also elsewhere on the board
unnamed: R18.2, S1.3

Notes on the sheet:
DNP
FORCE RESISTOR
I2C ADDRESS: GND = 0x68 1V8 = 0x69 OPEN = SPI
TACTILE BUTTON
PIN HEADERS
IMU
