rene6262/FAllyx_EVK/Fallyx_EVK-RevA.kicad_pcb

## KiCad design Fallyx_EVK-RevA.kicad_pcb (continued)

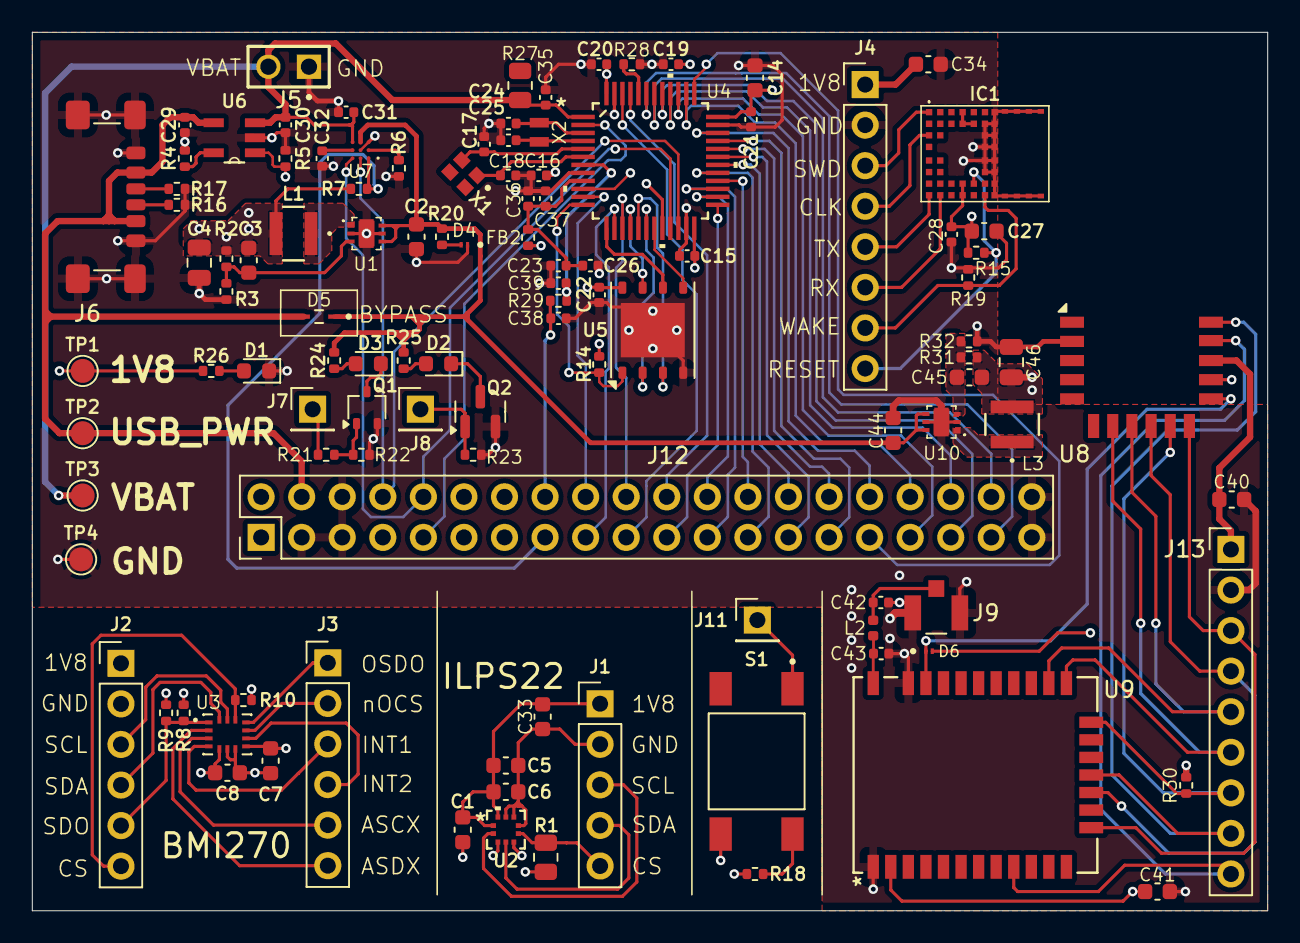
[picture p8: board Fallyx_EVK-RevA.kicad_pcb from above]

Board: 4 copper layers, 77.3 x 55.0 mm, 112 parts (0 on the bottom side), 95 nets.
