rene6262/FAllyx_EVK/(commit log)

2025-01-29 continued design work
    [Fallyx_EVK-RevA.kicad_pcb, Fallyx_EVK-RevA.kicad_sch, Fallyx_EVK_3.kicad_sch, Fallyx_EVK_4.kicad_sch, Fallyx_EVK_5.kicad_sch, Fallyx_EVK_6.kicad_sch]
2025-01-30 review edits
    [Fallyx_EVK-RevA.kicad_sch, Fallyx_EVK_2.kicad_sch, Fallyx_EVK_3.kicad_sch, Fallyx_EVK_4.kicad_sch, Fallyx_EVK_5.kicad_sch, Fallyx_EVK_6.kicad_sch]
2025-02-08 Updated for new BLE modules
    [2025-02-02_Fallyx_EVK _BOM-RevA.xlsx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]
2025-02-17 Final Routing and export for EVK
    [Fallyx_EVK _BOM.xlsx, Fallyx_EVK_5.kicad_sch, Fallyx_EVK_6.kicad_sch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]
